ischwia/51electronic-scale/320240.png

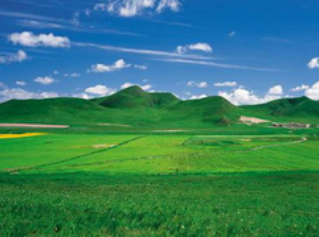
320240.png
