ischwia/51electronic-scale/IMG_20191111_110138.jpg

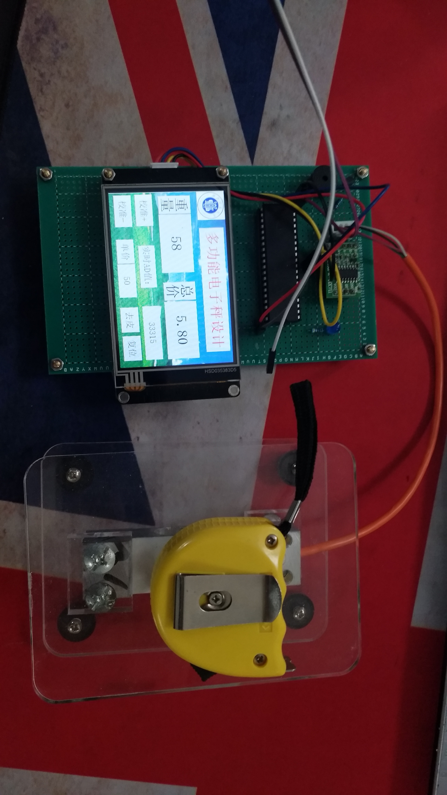
IMG_20191111_110138.jpg
