ischwia/51electronic-scale/README.md

# -51-
采用淘晶驰串口屏显示的多功能电子秤
1、采用HX711高速24位AD设计
2、量程为10kg，精度为1g
3、具有去皮称重，重量校准等功能
