ischwia/51electronic-scale/360截图18220210467363.png

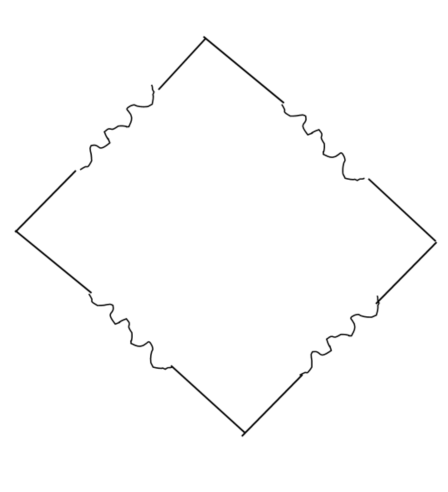
360截图18220210467363.png
