ischwia/51electronic-scale/IMG_20191018_202057.jpg

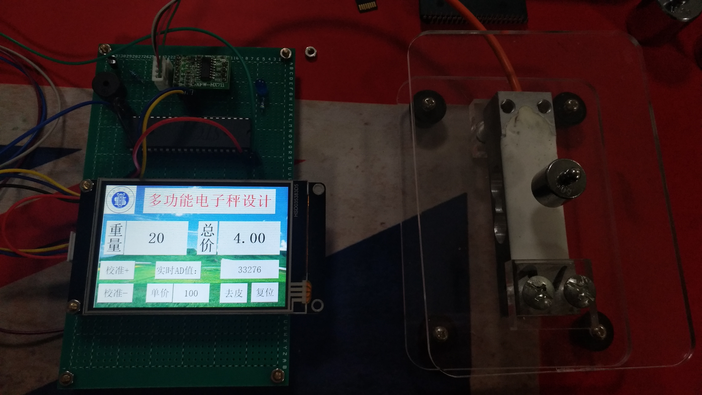
IMG_20191018_202057.jpg
