ischwia/51electronic-scale/流程图.jpg

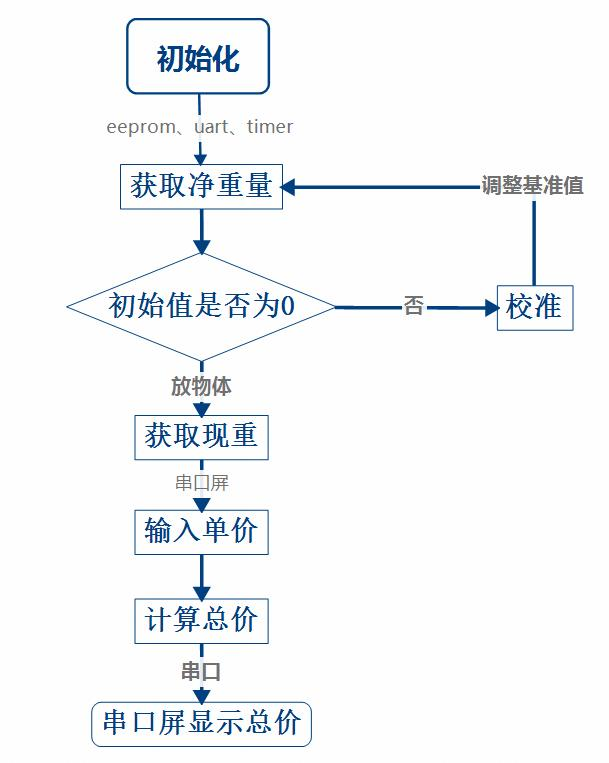
流程图.jpg
