ischwia/51electronic-scale/51电子秤.PDF

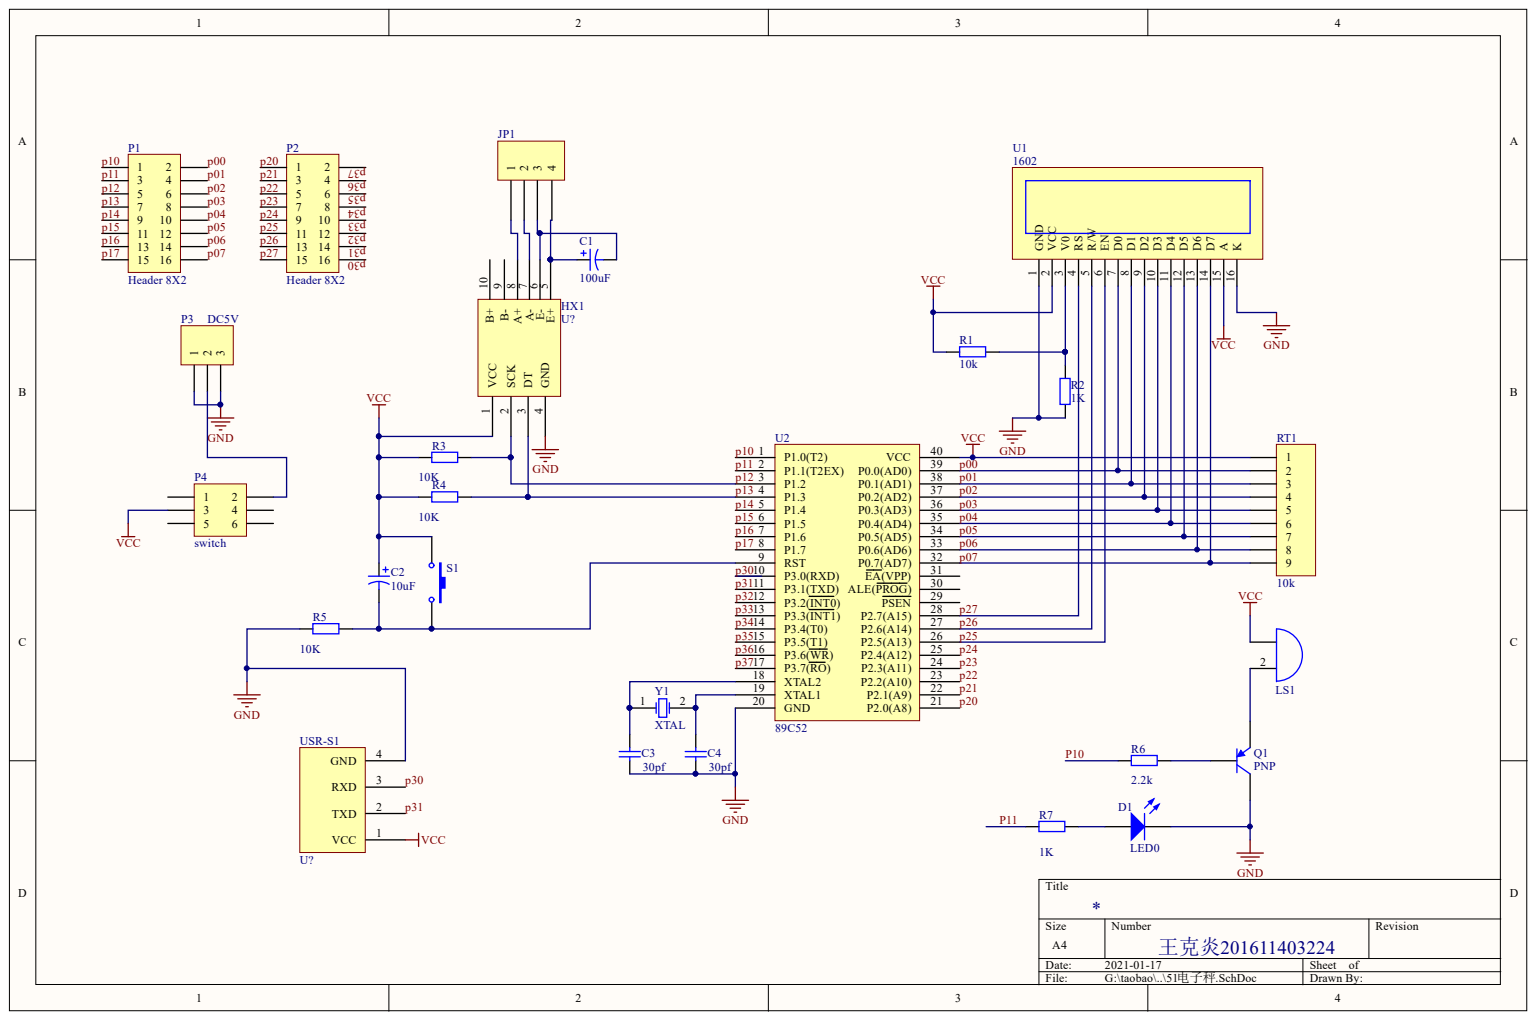
[picture p10: page 1]

R3
1 0 | | G N D | p 1 1 2 | p 0 0

p 3 0 1 0 | 3 | p 2 7
p 3 1 1 1 | 3 0

p 3 5 1 5 1 0 K | 22 P2.2(A10) 23 P2.3(A11) 24 P2.4(A12) 25 P2.5(A13) 26 P2.6(A14) 27 P2.7(A15) 28 PSEN 29 1 P2.1(A9) | p 2 5
