ischwia/51electronic-scale/(commit log)

2021-03-16 Create 代码
2024-07-02 已添加 未命名绘图.drawio
